mehmetskaya/High-Speed-Camera/Screenshot 2019-05-03 11.52.20.png

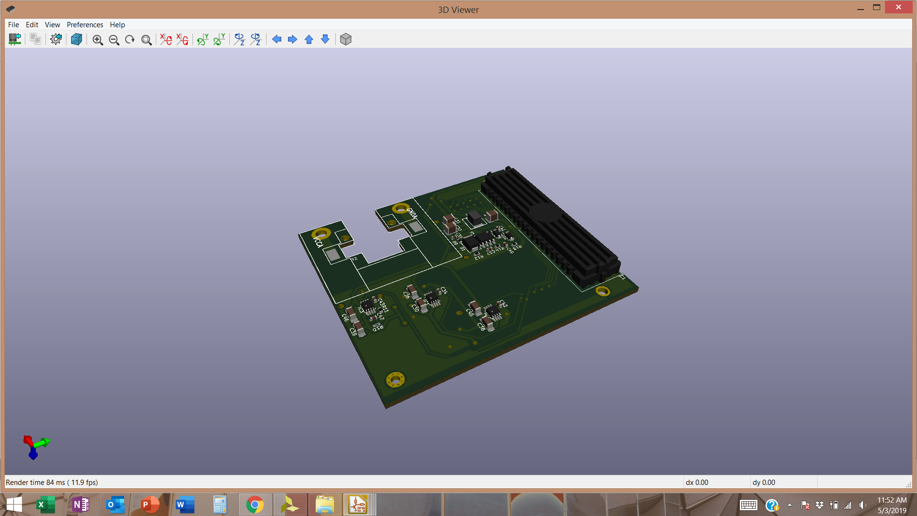
Screenshot 2019-05-03 11.52.20.png
