mehmetskaya/High-Speed-Camera/Screenshot 2019-05-03 11.53.14.png

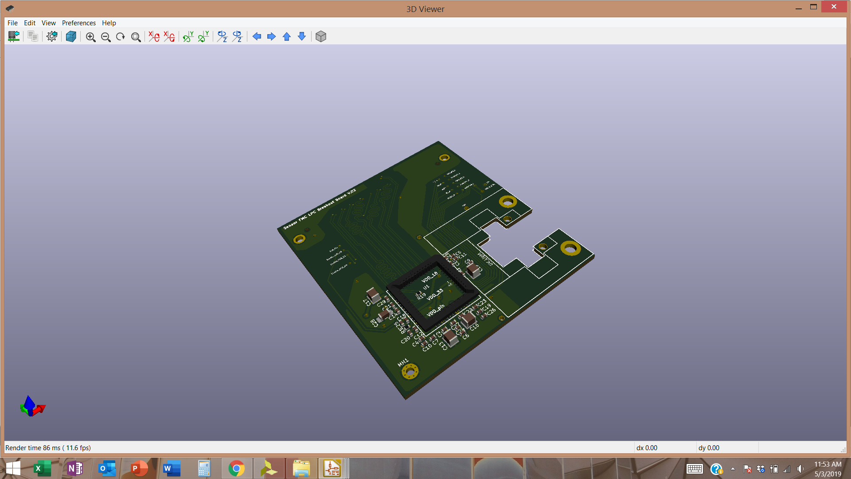
Screenshot 2019-05-03 11.53.14.png
