mehmetskaya/High-Speed-Camera/Screenshot 2019-05-03 11.53.30.png

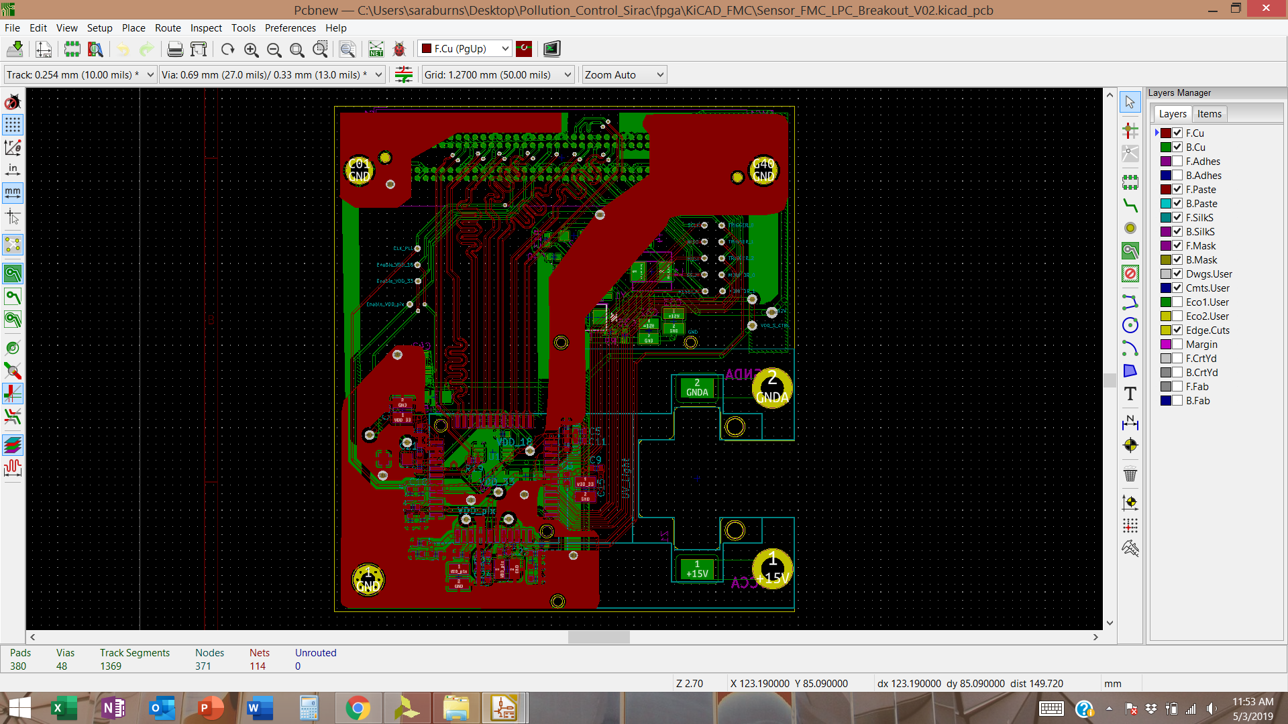
Screenshot 2019-05-03 11.53.30.png
