mehmetskaya/High-Speed-Camera/Sensor_FMC_LPC_Breakout_V02.pdf

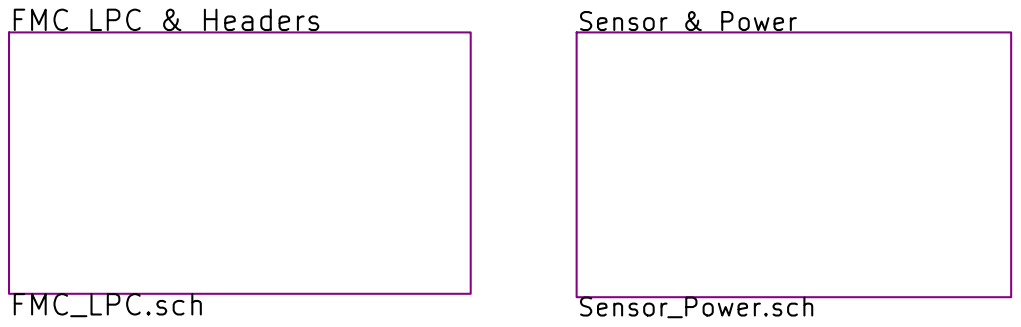
[picture p4: page 1]

File: Sensor_FMC_LPC_Breakout_V02.sch Sheet: / Pollution Control Technologies /MSK

Id: 1/3 Title: PYTHON 300/500/1300 FMC Breakout Board

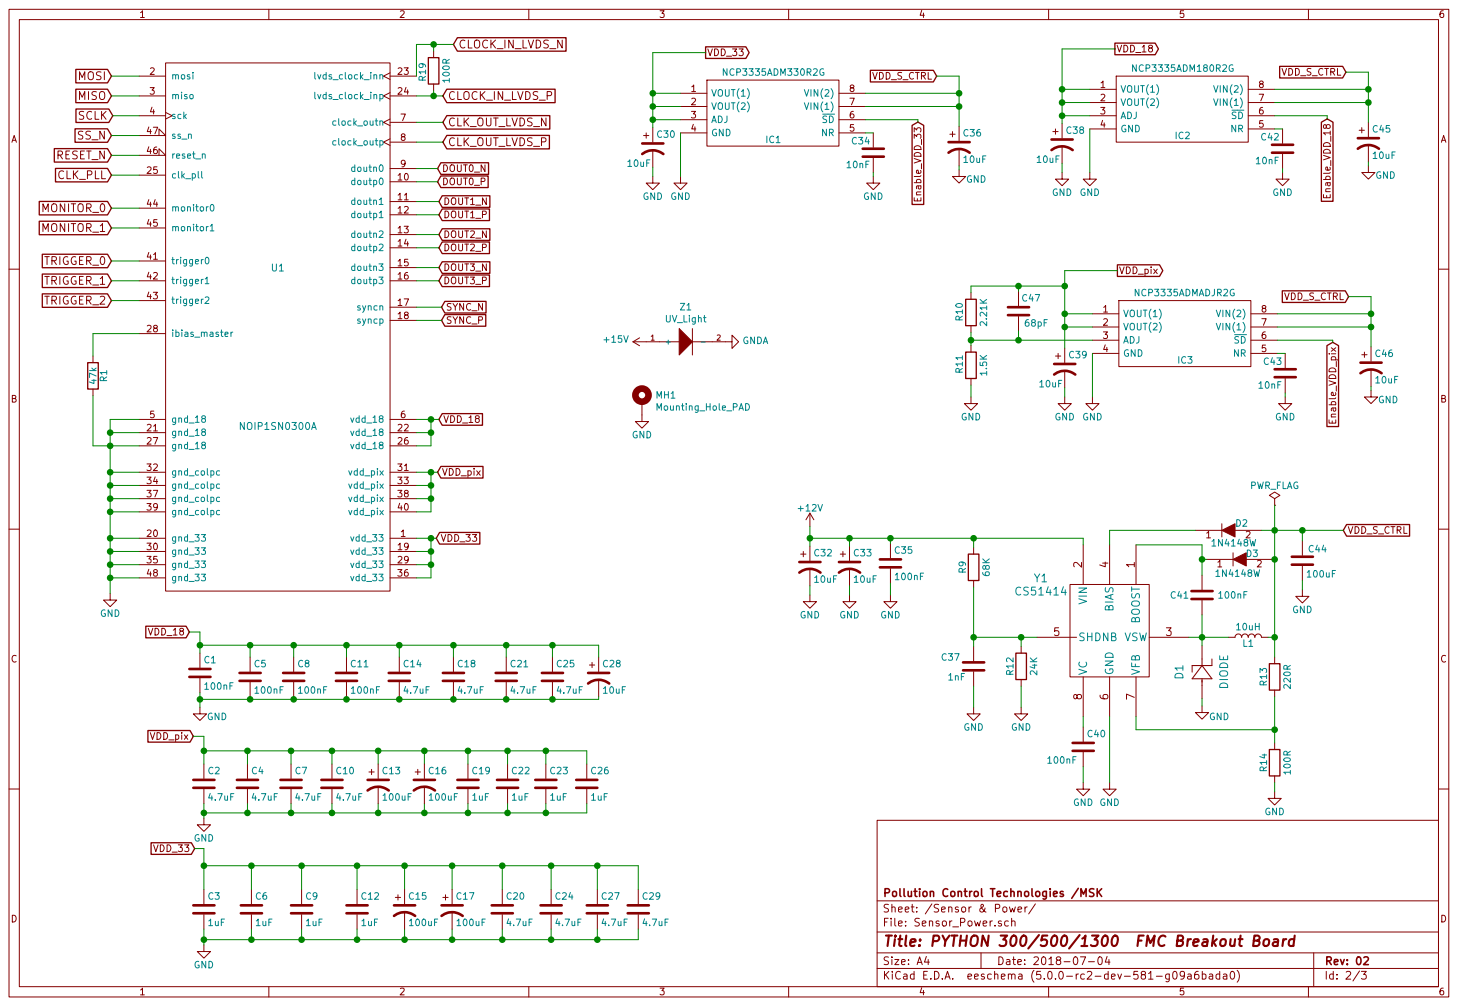
[picture p5: page 2]

File: Sensor_Power.sch Sheet: /Sensor & Power/ Pollution Control Technologies /MSK

Id: 2/3 Title: PYTHON 300/500/1300 FMC Breakout Board

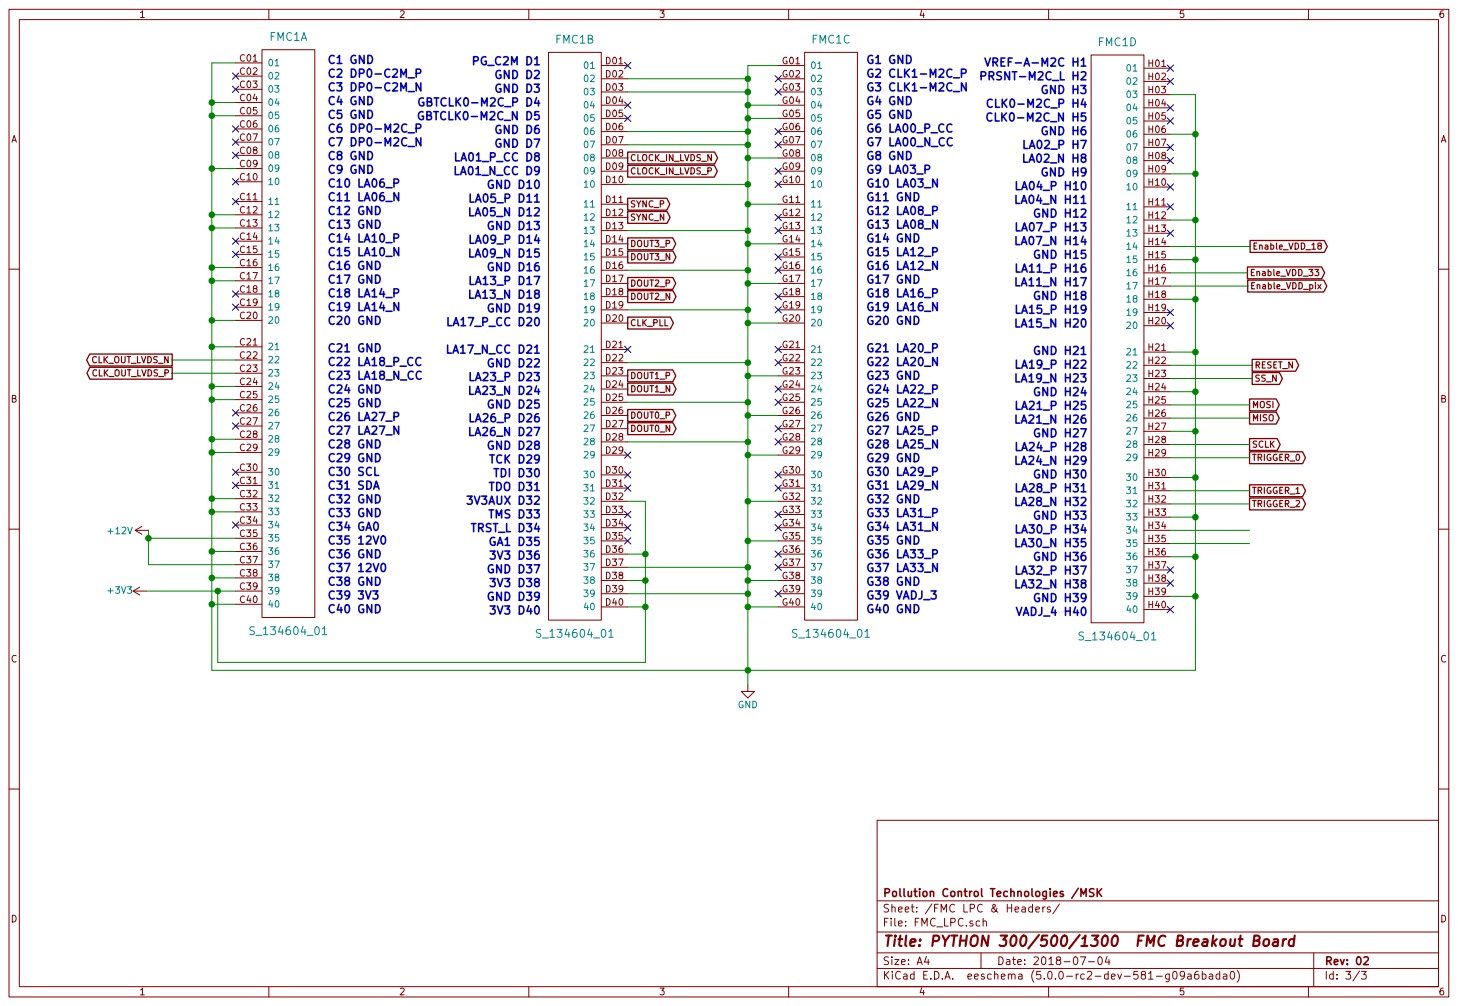
[picture p6: page 3]

File: FMC_LPC.sch Sheet: /FMC LPC & Headers/ Pollution Control Technologies /MSK

Id: 3/3 Title: PYTHON 300/500/1300 FMC Breakout Board
